SebBergmann/batbox-lightbeam-monitoring/04_images/lightbeam_components.jpg

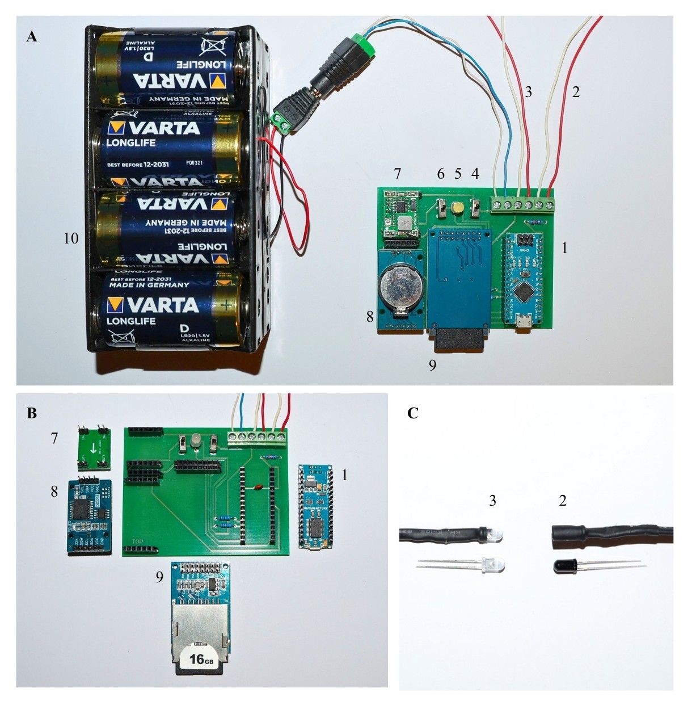
04_images/lightbeam_components.jpg
