SebBergmann/batbox-lightbeam-monitoring/04_images/box with lightbeam .jpg

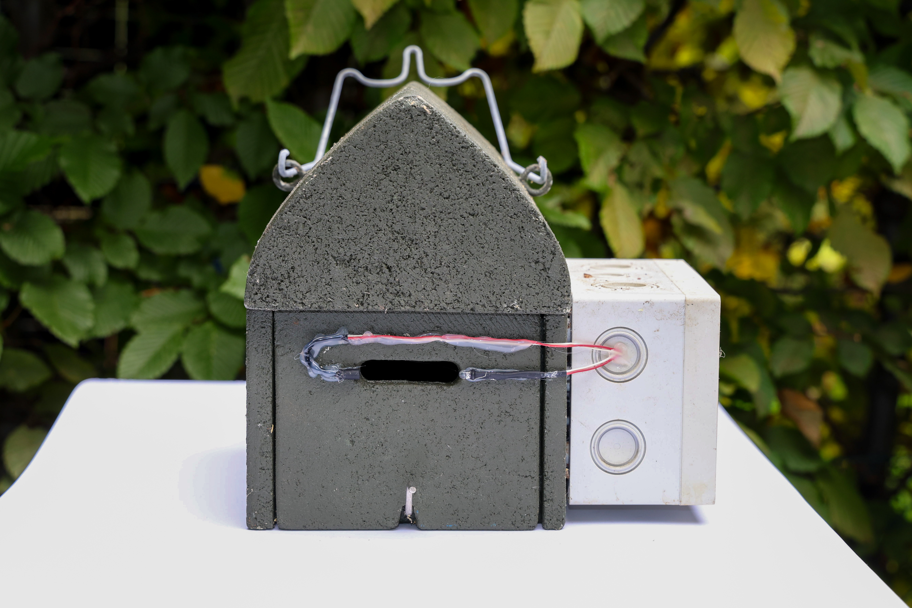
04_images/box with lightbeam .jpg
