SebBergmann/batbox-lightbeam-monitoring/03_BOM/BOM.xlsx

Group | Component | Quantity | Specification | size (LxBxH mm) | Supplier (example) | example cost (EUR)
Control & data
 | Microcontroller | 1 | Nano ATmega328 V3 Board Mikrocontroller | 45 x 48 x 7 | https://www.ebay.de/itm/356654194692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 | 4.89
 | Real Time Clock | 1 | RTC3231 | 37x21x6 | https://www.roboter-bausatz.de/p/rtc-ds3231-echtzeituhr-modul-fuer-arduino-ohne-batterie | 5.66
 | SD Modul | 1 | SPI, 3.3/5 V | 51 x 30 x 4 | https://www.ebay.de/itm/SD-Karten-Modul-SD-Card-Reader-Module-SPI-f%C3%BCr-Arduino-3-3V-5V/112283524505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 | 2.4
Power Supply
 | Step-Down-Modul | 1 | MP1584EN | 22 x 17 x 4 | https://www.reichelt.de/de/de/shop/produkt/entwicklerboards_-_spannungsregler_1_7_x_2_2_cm-282575?PROVID=2788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 | 6.59
 | Batteriehalter 8x Mono (D) | 1 | MPD BH48DW | 138 x 72 x 57 | https://www.conrad.de/de/p/mpd-bh48dw-batteriehalter-8x-mono-d-kabel-l-x-b-x-h-138-x-72-x-57-mm-1600310.html | 8.23
Light barrier
 | IR emitter diode | 1 | IR Led 5 mm 940nm |  | https://www.ebay.de/itm/12-Stuck-Photodiode-Fotodiode-plus-12-Stuck-Infrarot-IR-Led-5mm-940nm/202071812415 | 4.99
 | IR receiver diode | 1 | 5 mm, suitable for 940 nm |  | https://www.ebay.de/itm/12-Stuck-Photodiode-Fotodiode-plus-12-Stuck-Infrarot-IR-Led-5mm-940nm/202071812415
Indicators & switches
 | Duo LED | 1 | Durchlassstrom 20 mA, dreibeinig, Durchmesser 5 mm |  | https://www.ebay.de/itm/165480281271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 | 6.99
 | Kippschalter | 2 |  |  | https://www.ebay.de/itm/265038132385?_skw=kippschalter+arduino&itmmeta=01M4GDW5V659037JVZ793DH53N | 3.05
Passive components
 | Keramik Scheibenkondensator | 1 | 100 nF / 0.1 µF (“104”) |  | https://www.ebay.de/itm/385502977824?chn=ps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 | 1.62
 | Widerstand | 1 | 13 kOhm |  |  | 0.05
 | Widerstand | 2 | 360 Ohm |  |  | 0.05
 | Widerstand vor der Fotodiode | 1 | ggf messen, welcher Widerstand benötigt wird. Bei normaler Kabellänge am FLH 14 passen 220 Ohm |  |  | 0.05
PCB / wiring
 | Lochrasterplatine, doppelseitig | 1 | Rastermaß: 2.54 mm, Durchemsser pro Bohrung ca 1 mm | 90 x 70 x 16 | https://www.reichelt.de/de/de/shop/produkt/lochrasterplatine_doppelseitig_90_x_70_mm-319109?PROVID=2788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 | 2.6
 | Leiterplatte | 1 | alternativ zur Lochrasterplatine, Bestellung via Gerberdatei ab Stückzahl 1 möglich |  |  | 14.9
 | Klingeldraht | nach Bedarf | 0,2 mm²
 | Buchsenleisten + Pinleisten | nach Bedarf | 2,54 mm |  | https://www.ebay.de/itm/121854016867?itmmeta=01M4GEBNYS4BXF2BQ18PPKF2MH
 | Printklemmen | 6 Steckplätze |  |  | https://www.ebay.de/itm/50x-Printklemmen-Schraubklemmen-Anschlussklemmen-Leiterplattenklemme-RM-3-5-5-08/132100143009
 | DC Steckverbinder | 1 | Verbindung Batterihalter und PCB | 5,5 x 2,1 mm | https://www.ebay.de/itm/298181828464?itmmeta=01M4GF2QED3A4NPKQ3VNQ6VHVD&var=595222427926
Housing
 | Abzweigdose | 1 | IP66 | 176 x 176 x 126 | https://www.conrad.de/de/p/kopos-ksk-175-ka-abzweigdose-halogenfrei-l-x-b-x-h-176-x-176-x-126-mm-1-st-1525532.html | 12.6
