SebBergmann/batbox-lightbeam-monitoring/01_hardware/kicad/lightbeam.kicad_pcb

## KiCad design 01_hardware/kicad/lightbeam.kicad_pcb (2026-10-10)

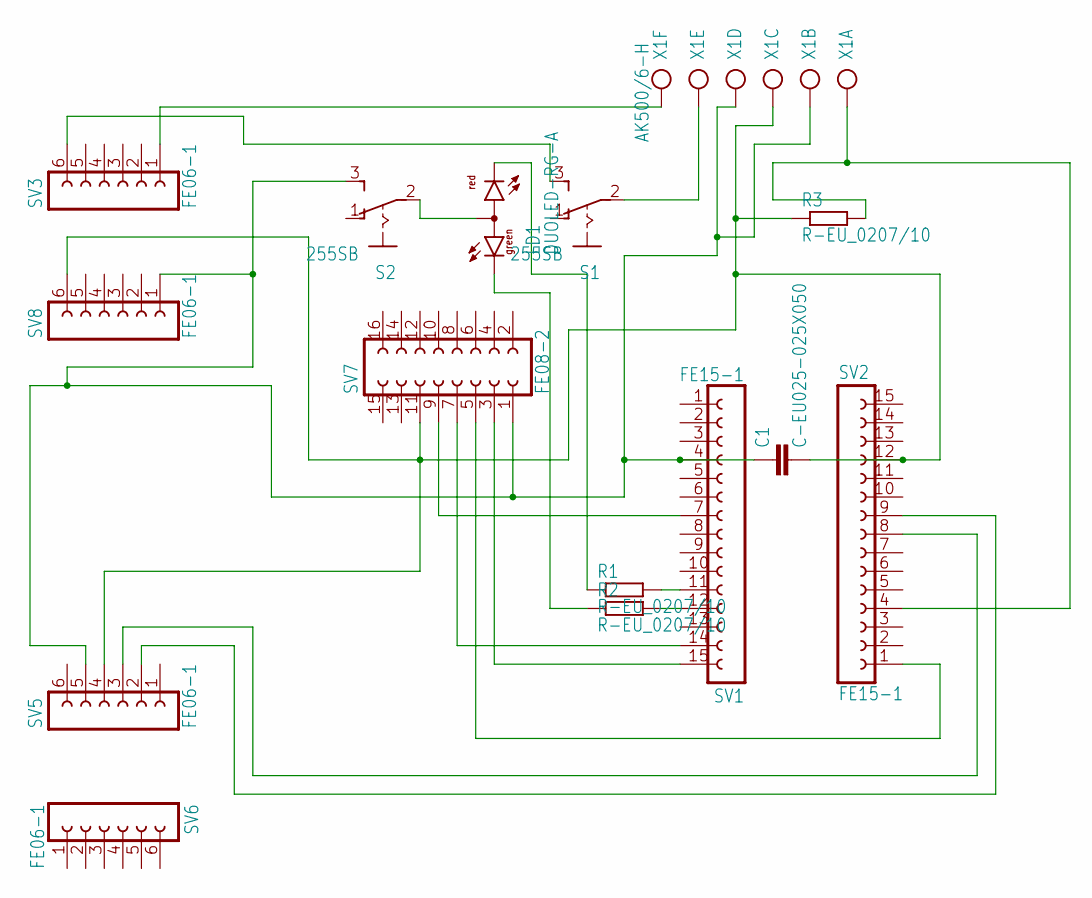
[picture p3: schematic lightbeam.kicad_sch]

Parts:
C1: C-EU025-025X050; C025-025X050
LD1: DUOLED-RG-A; DUOLED-A-5MM
R1, R2, R3: R-EU_0207/10; 0207_10
S1, S2: 255SB
SV1, SV2: FE15-1; FE15
SV3, SV5, SV6, SV8: FE06-1; FE06
SV7: FE08-2
X1: AK500/6-H; AK500_6-H

Connections:
unnamed: LD1.CX (CG), R2.1
unnamed: LD1.CR, R1.1
unnamed: R1.2, SV1.11
unnamed: R2.2, SV1.12
unnamed: S1.2, X1.5 (KL)
unnamed: S1.3 (S), SV3.6
unnamed: LD1.A, S2.2
unnamed: C1.1, S2.3 (S), SV1.4, SV5.5, SV7.1, SV8.1, X1.2 (KL), X1.4 (KL)
unnamed: SV1.7, SV7.9
unnamed: SV1.14, SV7.7
unnamed: SV1.15, SV7.3
unnamed: SV2.1, SV7.5
unnamed: SV2.8, SV5.3
unnamed: SV2.9, SV5.2
unnamed: R3.2, SV2.4, X1.1 (KL)
unnamed: C1.2, R3.1, SV2.12, SV5.4, SV7.11, SV8.6, X1.3 (KL)
unnamed: SV3.1, X1.6 (KL)

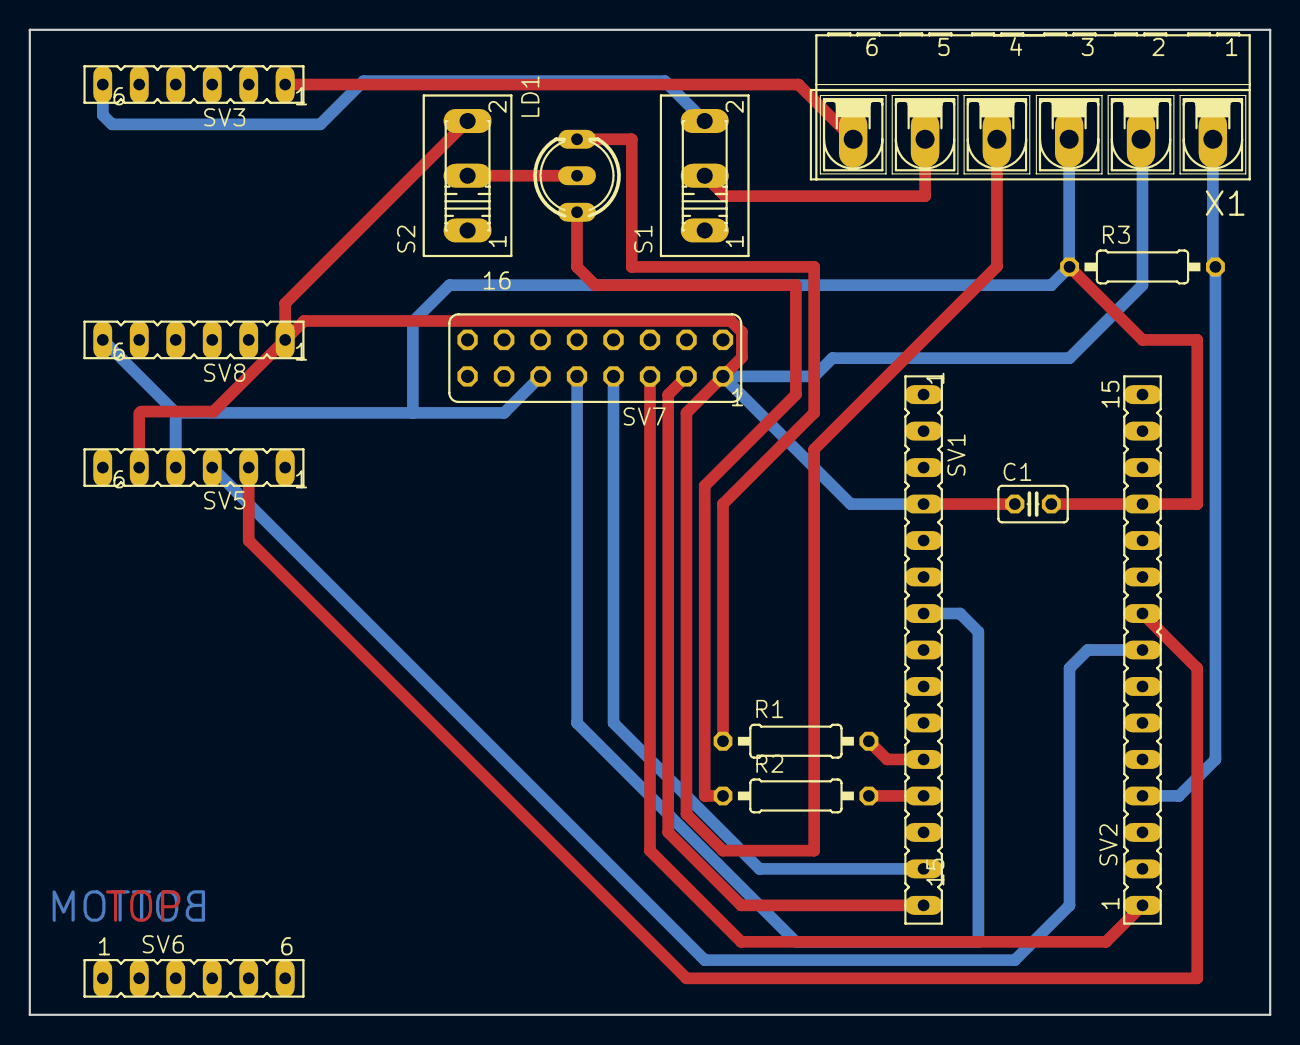
[picture p4: board lightbeam.kicad_pcb from above]

Board: 2 copper layers, 86.4 x 68.6 mm, 15 parts (0 on the bottom side), 17 nets.
